stevemarple/FLC100_shield/README.md

FLC100_shield
=============

Shield for FLC100 fluxgate magnetometer
