stevemarple/FLC100_shield/hardware/remote_v1.1/FLC100_remote_v1.1.brd

## EAGLE design hardware/remote_v1.1/FLC100_remote_v1.1.brd (2012-09-07)

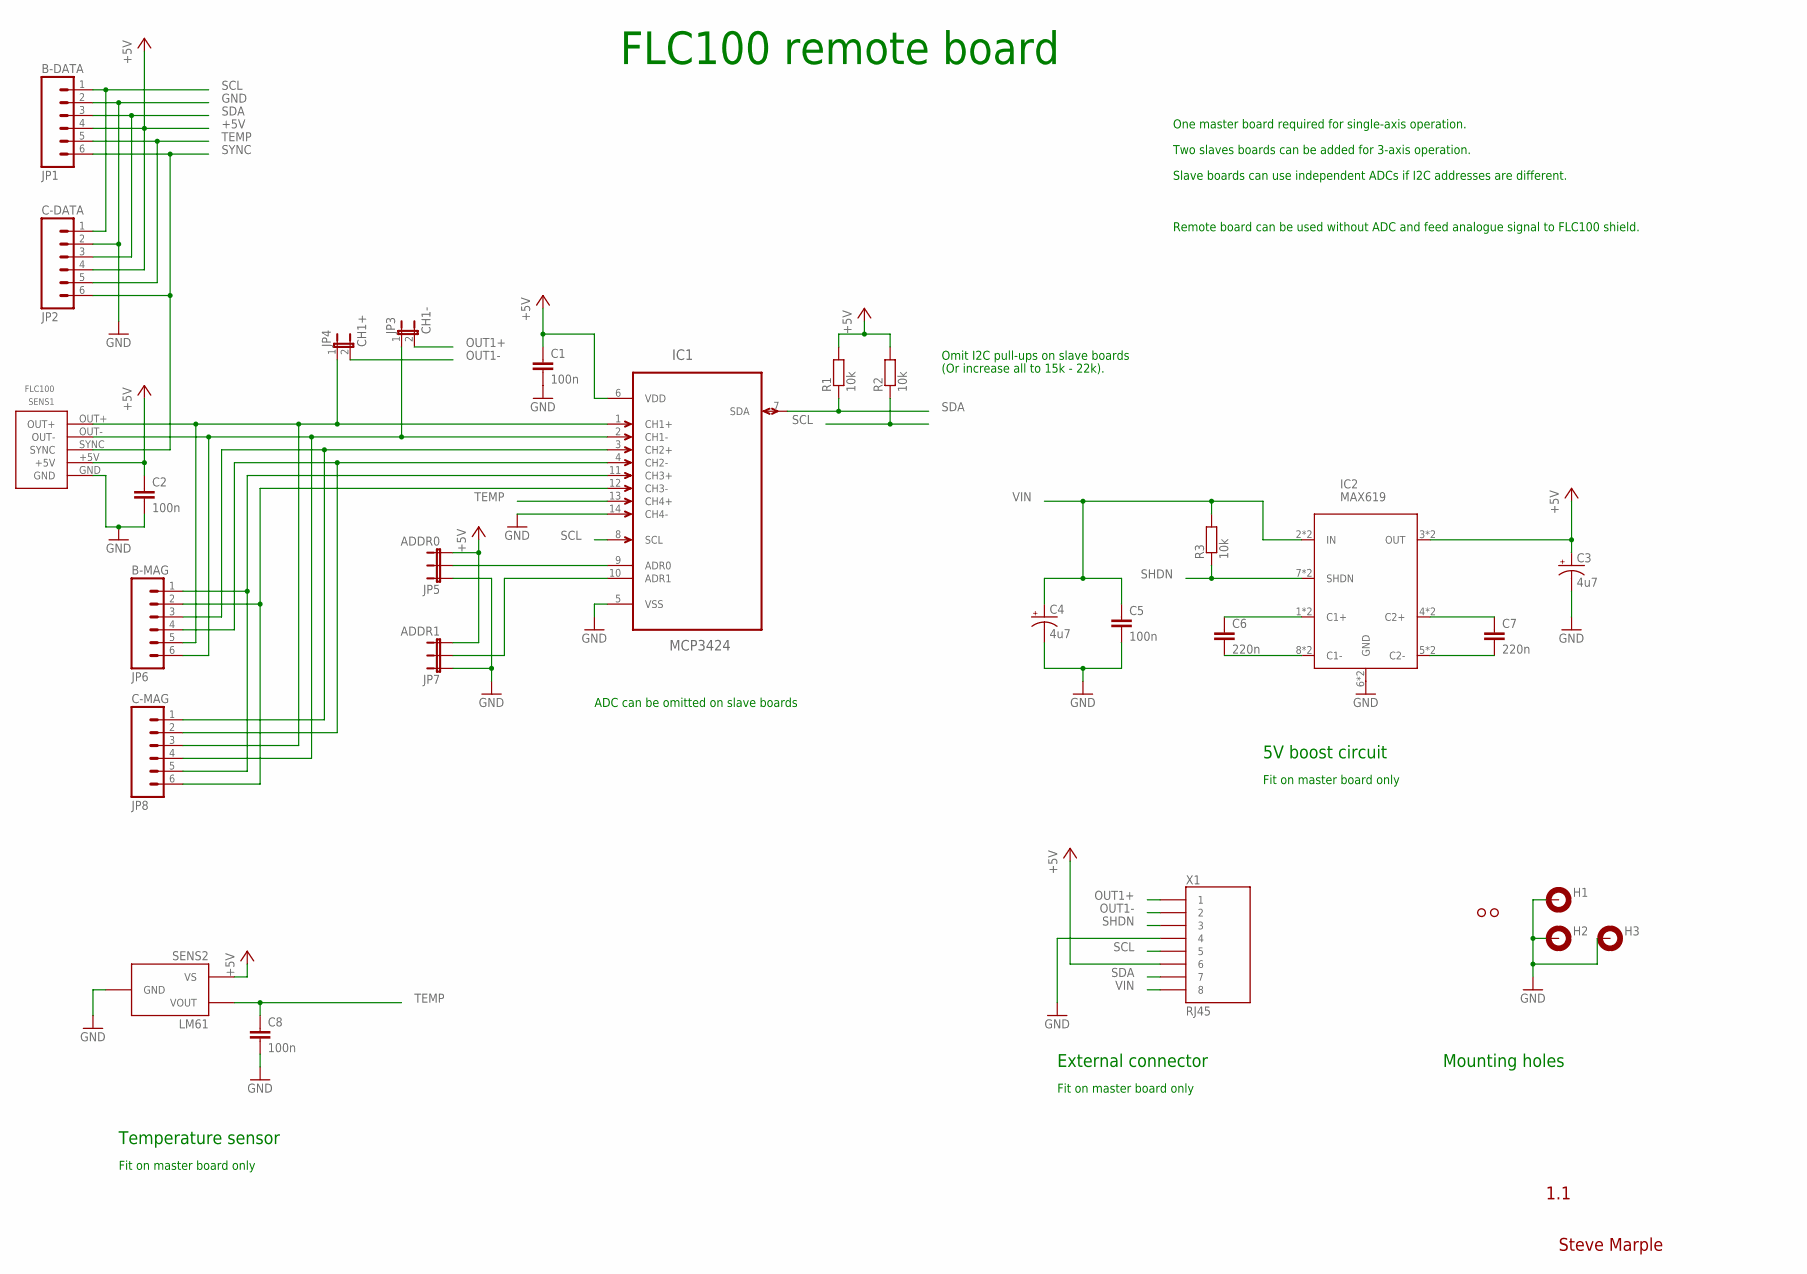
[picture p1: schematic FLC100_remote_v1.1.sch]

Parts:
C1, C2, C5, C8: 100n; CAP-PTH-SMALL
C3, C4: 4u7; CPOL-RADIAL-10UF-25V
C6, C7: 220n; CAP-PTH-5MM
H1, H2, H3: MOUNT-PAD-ROUND3.0; 3,0-PAD
IC1: MCP3424; SOIC127P600X175-14N
IC2: MAX619; DIL08-SOIC8
JP1: B-DATA; 1X06_FEMALE
JP2: C-DATA; 1X06_FEMALE
JP3: CH1-; 1X02
JP4: CH1+; 1X02
JP5: ADDR0; 1X03
JP6: B-MAG; 1X06_FEMALE
JP7: ADDR1; 1X03
JP8: C-MAG; 1X06_FEMALE
R1, R2, R3: 10k; RES-AXIAL-0.4
SENS1: FLC100
SENS2: LM61; TO-92
U$1, U$2: PAD
X1: RJ45; RJ45-8

Connections:
+5V: C1.1, C2.1, C3.1 (+), IC1.6 (VDD), IC2.3 (OUT), IC2.3@1 (OUT), JP1.4, JP2.4, JP5.3, JP7.3, R1.P$2 (2), R2.P$2 (2), SENS1.+5V, SENS2.1 (VS), X1.6
GND: C1.2, C2.2, C3.2 (-), C4.2 (-), C5.2, C8.2, H1.B3,0, H2.B3,0, H3.B3,0, IC1.5 (VSS), IC1.14 (CH4-), IC2.6 (GND), IC2.6@1 (GND), JP1.2, JP2.2, JP5.1, JP7.1, SENS1.GND, SENS2.3 (GND), X1.4
unnamed: IC1.1 (CH1+), JP4.1, JP6.5, JP8.3, SENS1.OUT+
unnamed: IC1.2 (CH1-), JP3.1, JP6.6, JP8.4, SENS1.OUT-
unnamed: IC1.3 (CH2+), JP6.3, JP8.1
unnamed: IC1.4 (CH2-), JP6.4, JP8.2
unnamed: C6.2, IC2.8 (C1-), IC2.8@1 (C1-)
unnamed: C6.1, IC2.1 (C1+), IC2.1@1 (C1+)
unnamed: IC1.11 (CH3+), JP6.1, JP8.5
unnamed: IC1.12 (CH3-), JP6.2, JP8.6
unnamed: IC1.9 (ADR0), JP5.2
unnamed: IC1.10 (ADR1), JP7.2
unnamed: C7.1, IC2.4 (C2+), IC2.4@1 (C2+)
unnamed: C7.2, IC2.5 (C2-), IC2.5@1 (C2-)
OUT1+: JP3.2, X1.1
OUT1-: JP4.2, X1.2
SCL: IC1.8 (SCL), JP1.1, JP2.1, R2.P$1 (1), X1.5
SDA: IC1.7 (SDA), JP1.3, JP2.3, R1.P$1 (1), X1.7
SHDN: IC2.7 (SHDN), IC2.7@1 (SHDN), R3.P$1 (1), X1.3
SYNC: JP1.6, JP2.6, SENS1.SYNC
TEMP: C8.1, IC1.13 (CH4+), JP1.5, JP2.5, SENS2.2 (VOUT)
VIN: C4.1 (+), C5.1, IC2.2 (IN), IC2.2@1 (IN), R3.P$2 (2), X1.8

Notes on the sheet:
1.1
Steve Marple
External connector
5V boost circuit
ADC can be omitted on slave boards
Fit on master board only
FLC100 remote board
One master board required for single-axis operation.
Two slaves boards can be added for 3-axis operation.
Slave boards can use independent ADCs if I2C addresses are different.
Remote board can be used without ADC and feed analogue signal to FLC100 shield.
Omit I2C pull-ups on slave boards
(Or increase all to 15k - 22k).
Mounting holes
Temperature sensor

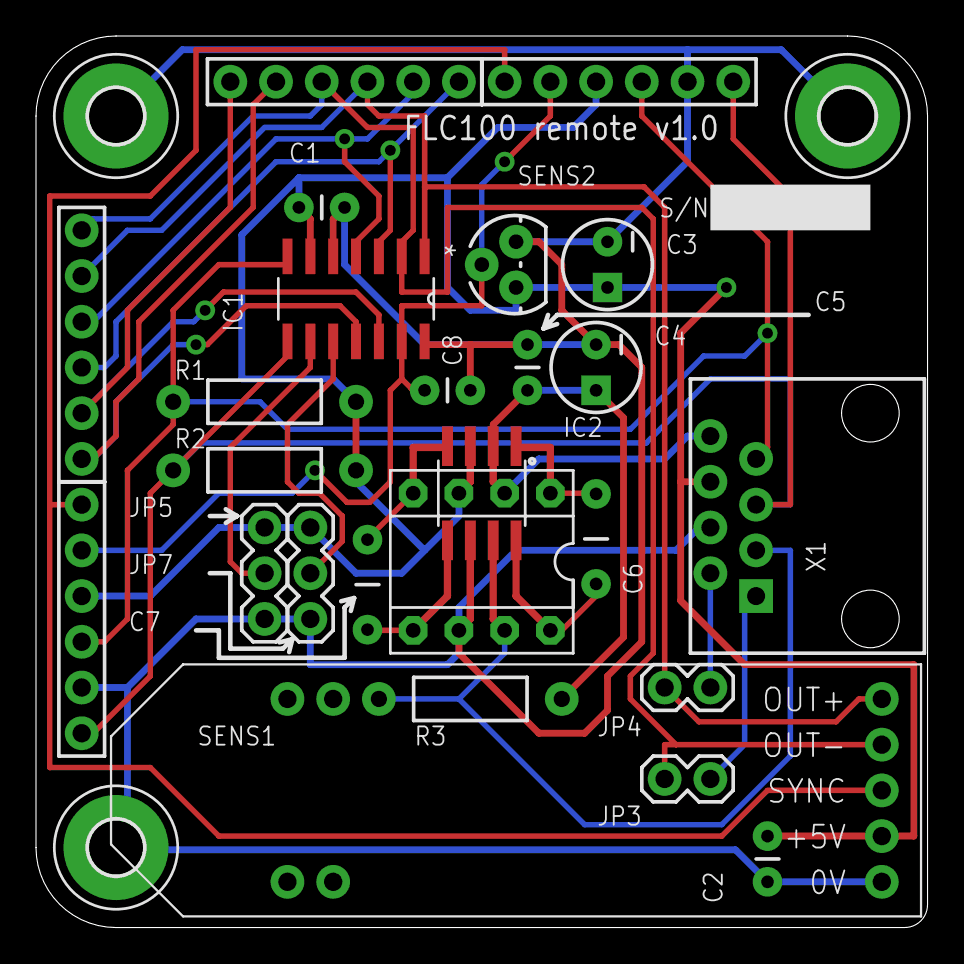
[picture p2: board FLC100_remote_v1.1.brd from above]

Board: 2 copper layers, 49.5 x 49.5 mm, 29 parts (0 on the bottom side), 22 nets.
