stevemarple/FLC100_shield/hardware/shield_v1.0/FLC100_shield_v1.0.brd

## EAGLE design hardware/shield_v1.0/FLC100_shield_v1.0.brd (2012-09-07)

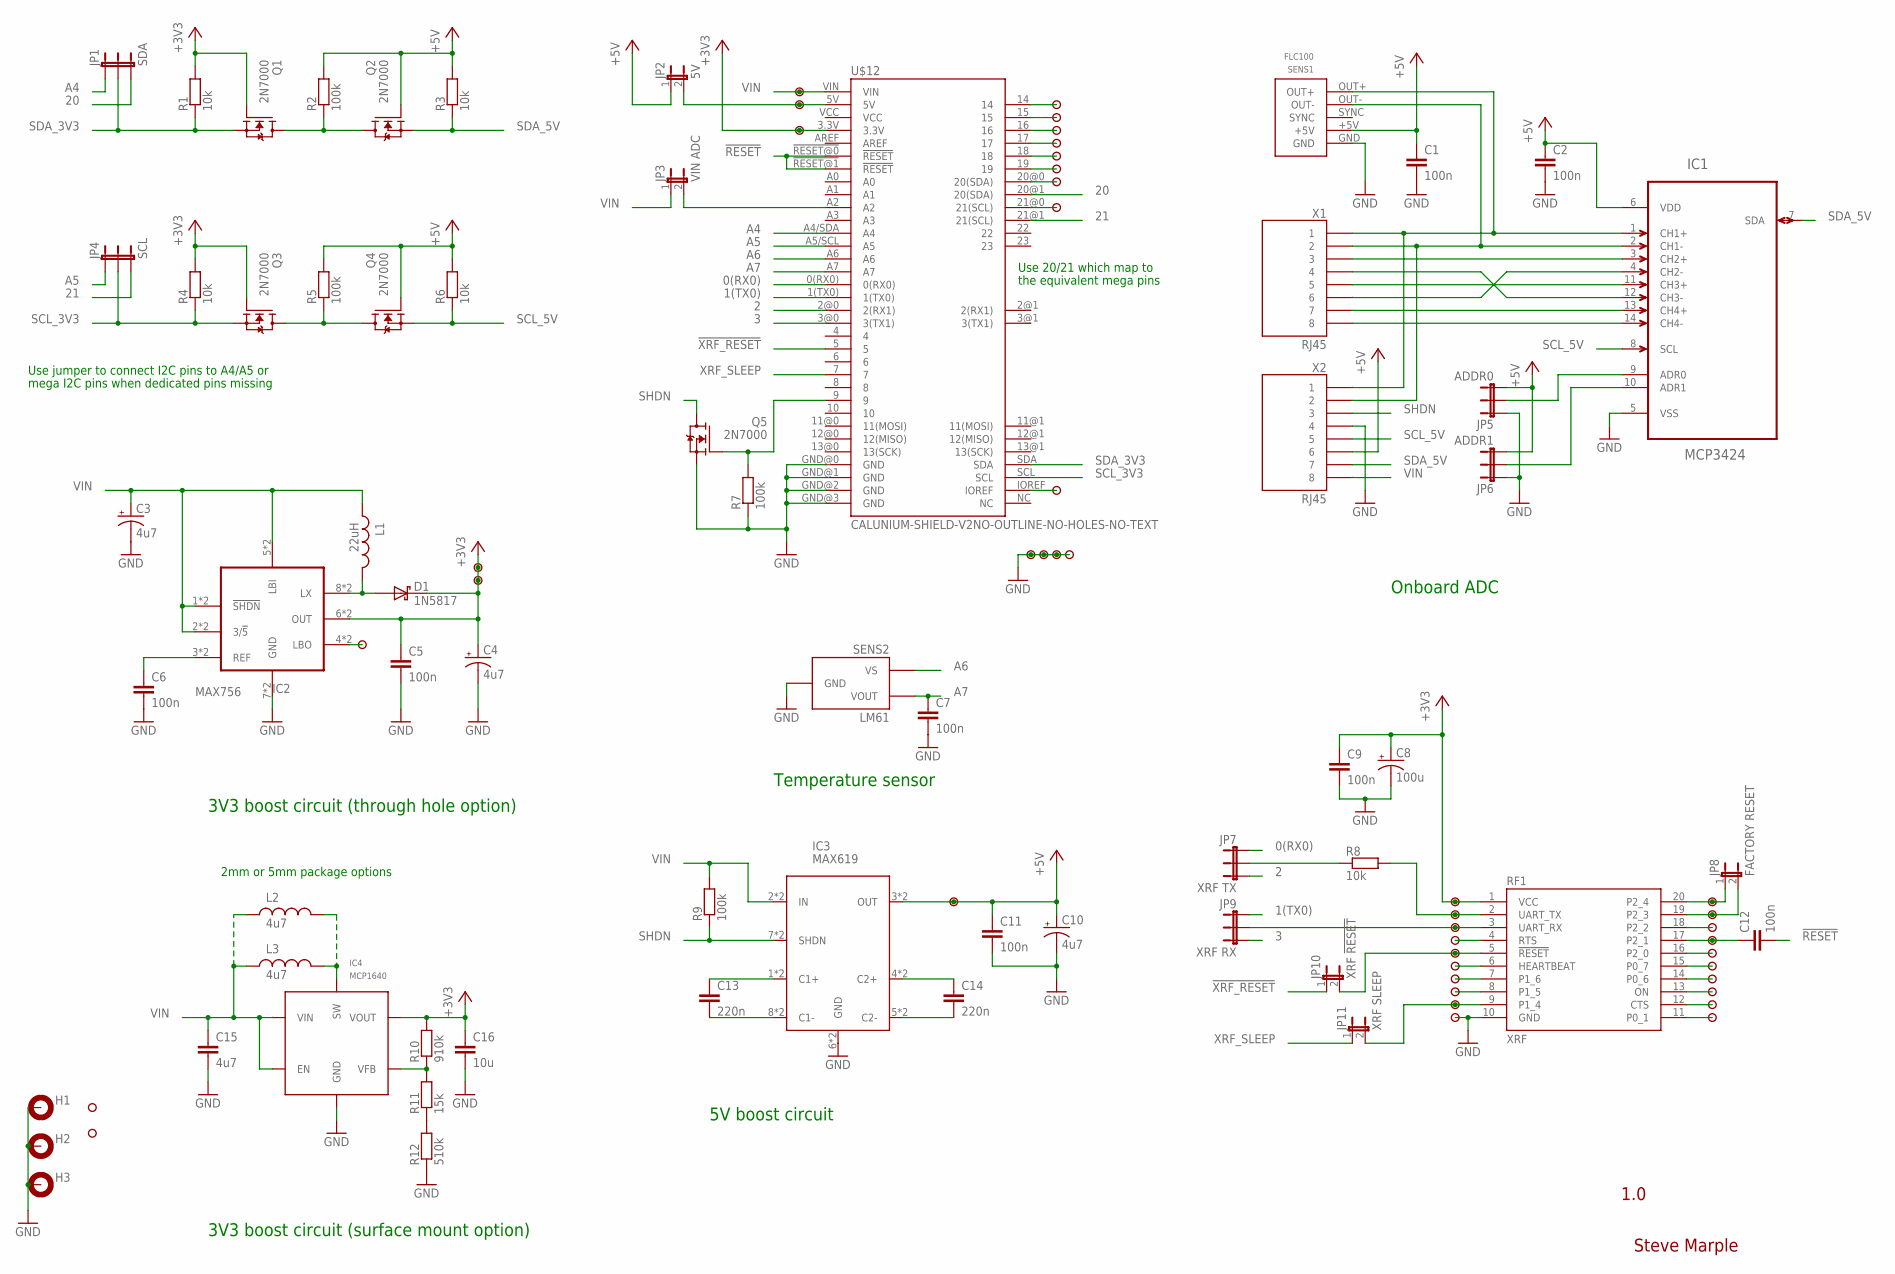
[picture p3: schematic FLC100_shield_v1.0.sch]

Parts:
C1, C2, C5, C6, C7, C9, C11, C12: 100n; CAP-PTH-SMALL
C3, C4, C10: 4u7; CPOL-RADIAL-10UF-25V
C8: 100u; CPOL-RADIAL-10UF-25V
C13, C14: 220n; CAP-PTH-5MM
C15: 4u7; 1206-HAND
C16: 10u; 1206-HAND
D1: 1N5817; DIODE-TH-0.4
H1, H2, H3: MOUNT-PAD-ROUND3.0; 3,0-PAD
IC1: MCP3424; SOIC127P600X175-14N
IC2: MAX756; DIL08-SOIC8
IC3: MAX619; DIL08-SOIC8
IC4: MCP1640; SOT23-6
JP1: SDA; 1X03
JP2: 5V; 1X02
JP3: VIN ADC; 1X02
JP4: SCL; 1X03
JP5: ADDR0; 1X03
JP6: ADDR1; 1X03
JP7: XRF TX; 1X03
JP8: FACTORY RESET; 1X02
JP9: XRF RX; 1X03
JP10: XRF !RESET; 1X02
JP11: XRF SLEEP; 1X02
L1: 22uH; INDUCTOR-TH-5MM
L2: 4u7; INDUCTOR-TH-2MM
L3: 4u7; INDUCTOR-TH-5MM
Q1, Q2, Q3, Q4, Q5: 2N7000; TO-92
R1, R3, R4, R6, R8: 10k; RES-AXIAL-0.4
R2, R5, R7, R9: 100k; RES-AXIAL-0.4
R10: 910k; 1206-HAND
R11: 15k; 1206-HAND
R12: 510k; 1206-HAND
RF1: XRF; XBEE
SENS1: FLC100
SENS2: LM61; TO-92
U$1, U$2, U$3, U$4, U$5, U$6, U$7, U$8, U$9, U$10, U$11, U$13, U$14, U$15, U$16, U$17, U$18, U$19, U$20, U$21, U$22, U$23, U$24, U$25, U$26, U$27, U$28, U$29, U$30, U$31, U$32, U$33, U$34, U$35, U$36, U$37, U$38, U$39, U$40, U$41, U$42, U$43: PAD
U$12: CALUNIUM-SHIELD-V2NO-OUTLINE-NO-HOLES-NO-TEXT; CALUNIUM-SHIELD-NO-OUTLINE-NO-HOLES-NO-TEXT-V2
X1, X2: RJ45; RJ45-8

Connections:
0(RX0): JP7.1, U$12.0(RX0)
1(TX0): JP9.1, U$12.1(TX0)
2: JP7.3, U$12.2@0 (2(RX1))
3: JP9.3, U$12.3@0 (3(TX1))
20: JP1.3, U$12.20@1 (20(SDA))
21: JP4.3, U$12.21@1 (21(SCL))
!RESET: C12.2, U$12.!RESET@0 (!RESET), U$12.!RESET@1 (!RESET)
!XRF_RESET: JP10.1, U$12.5
+3V3: C4.1 (+), C5.1, C8.1 (+), C9.1, C16.1, D1.C, IC2.6 (OUT), IC2.6@1 (OUT), IC4.5 (VOUT), Q1.2 (G), Q3.2 (G), R1.P$2 (2), R4.P$2 (2), R10.2, RF1.1 (VCC), U$5.1, U$12.3.3V, U$18.1, U$19.1, U$22.1
+5V: C1.1, C2.1, C10.1 (+), C11.1, IC1.6 (VDD), IC3.3 (OUT), IC3.3@1 (OUT), JP2.1, JP5.3, JP6.3, Q2.2 (G), Q4.2 (G), R2.P$2 (2), R3.P$2 (2), R5.P$2 (2), R6.P$2 (2), SENS1.+5V, U$21.1, X2.6
A4: JP1.1, U$12.A4/SDA (A4)
A5: JP4.1, U$12.A5/SCL (A5)
A6: SENS2.1 (VS), U$12.A6
A7: C7.1, SENS2.2 (VOUT), U$12.A7
CHECK1: IC1.9 (ADR0), JP5.2
CHECK2: IC1.10 (ADR1), JP6.2
GND: C1.2, C2.2, C3.2 (-), C4.2 (-), C5.2, C6.2, C7.2, C8.2 (-), C9.2, C10.2 (-), C11.2, C15.2, C16.2, H1.B3,0, H2.B3,0, H3.B3,0, IC1.5 (VSS), IC2.7 (GND), IC2.7@1 (GND), IC3.6 (GND), IC3.6@1 (GND), IC4.2 (GND), JP5.1, JP6.1, Q5.1 (S), R7.P$1 (1), R12.1, RF1.10 (GND), SENS1.GND, SENS2.3 (GND), U$12.GND@0 (GND), U$12.GND@1 (GND), U$12.GND@2 (GND), U$12.GND@3 (GND), U$14.1, U$15.1, U$16.1, U$17.1, U$40.1, X2.4
unnamed: Q1.3 (D), Q2.3 (D), R2.P$1 (1)
unnamed: Q3.3 (D), Q4.3 (D), R5.P$1 (1)
unnamed: C13.2, IC3.8 (C1-), IC3.8@1 (C1-)
unnamed: C13.1, IC3.1 (C1+), IC3.1@1 (C1+)
unnamed: C14.1, IC3.4 (C2+), IC3.4@1 (C2+)
unnamed: C14.2, IC3.5 (C2-), IC3.5@1 (C2-)
unnamed: JP8.1, RF1.20 (P2_4), U$23.1
unnamed: JP8.2, RF1.19 (P2_3), U$25.1
unnamed: R8.P$2 (2), RF1.2 (UART_TX), U$24.1
unnamed: JP9.2, RF1.3 (UART_RX), U$26.1
unnamed: RF1.4 (RTS), U$28.1
unnamed: JP10.2, RF1.5 (!RESET), U$30.1
unnamed: RF1.6 (HEARTBEAT), U$32.1
unnamed: RF1.7 (P1_6), U$34.1
unnamed: RF1.8 (P1_5), U$36.1
unnamed: JP11.2, RF1.9 (P1_4), U$38.1
unnamed: RF1.18 (P2_2), U$27.1
unnamed: C12.1, RF1.17 (P2_1), U$29.1
unnamed: RF1.16 (P2_0), U$31.1
unnamed: RF1.15 (P0_7), U$33.1
unnamed: RF1.14 (P0_6), U$35.1
unnamed: RF1.13 (ON), U$37.1
unnamed: RF1.12 (CTS), U$39.1
unnamed: RF1.11 (P0_1), U$41.1
unnamed: IC2.4 (LBO), IC2.4@1 (LBO), U$20.1
unnamed: Q5.2 (G), R7.P$2 (2), U$12.9
unnamed: JP3.2, U$12.A2
unnamed: JP7.2, R8.P$1 (1)
unnamed: JP2.2, U$2.1, U$12.5V
unnamed: D1.A, IC2.8 (LX), IC2.8@1 (LX), L1.P$2 (2)
unnamed: C6.1, IC2.3 (REF), IC2.3@1 (REF)
unnamed: IC1.1 (CH1+), SENS1.OUT+, X1.1, X2.1
unnamed: IC1.2 (CH1-), SENS1.OUT-, X1.2, X2.2
unnamed: IC1.3 (CH2+), X1.3
unnamed: IC1.4 (CH2-), X1.6
unnamed: IC1.11 (CH3+), X1.5
unnamed: IC1.12 (CH3-), X1.4
unnamed: IC1.13 (CH4+), X1.7
unnamed: IC1.14 (CH4-), X1.8
unnamed: U$11.1, U$12.21@0 (21(SCL))
unnamed: IC4.1 (SW), L2.P$2 (2), L3.P$2 (2)
unnamed: R11.1, R12.2
unnamed: U$3.1, U$12.14
unnamed: U$4.1, U$12.15
unnamed: U$6.1, U$12.16
unnamed: IC4.4 (VFB), R10.1, R11.2
unnamed: U$7.1, U$12.17
unnamed: U$8.1, U$12.18
unnamed: U$9.1, U$12.19
unnamed: U$10.1, U$12.20@0 (20(SDA))
unnamed: U$12.IOREF, U$13.1
SCL_3V3: JP4.2, Q3.1 (S), R4.P$1 (1), U$12.SCL
SCL_5V: IC1.8 (SCL), Q4.1 (S), R6.P$1 (1), X2.5
SDA_3V3: JP1.2, Q1.1 (S), R1.P$1 (1), U$12.SDA
SDA_5V: IC1.7 (SDA), Q2.1 (S), R3.P$1 (1), X2.7
SHDN: IC3.7 (SHDN), IC3.7@1 (SHDN), Q5.3 (D), R9.P$1 (1), X2.3
VIN: C3.1 (+), C15.1, IC2.1 (!SHDN), IC2.1@1 (!SHDN), IC2.2 (3/!5), IC2.2@1 (3/!5), IC2.5 (LBI), IC2.5@1 (LBI), IC3.2 (IN), IC3.2@1 (IN), IC4.3 (EN), IC4.6 (VIN), JP3.1, L1.P$1 (1), L2.P$1 (1), L3.P$1 (1), R9.P$2 (2), U$1.1, U$12.VIN, X2.8
XRF_SLEEP: JP11.1, U$12.7

Notes on the sheet:
1.0
Steve Marple
Use jumper to connect I2C pins to A4/A5 or
3V3 boost circuit (through hole option)
Use 20/21 which map to
the equivalent mega pins
2mm or 5mm package options
mega I2C pins when dedicated pins missing
3V3 boost circuit (surface mount option)
Onboard ADC
5V boost circuit
Temperature sensor

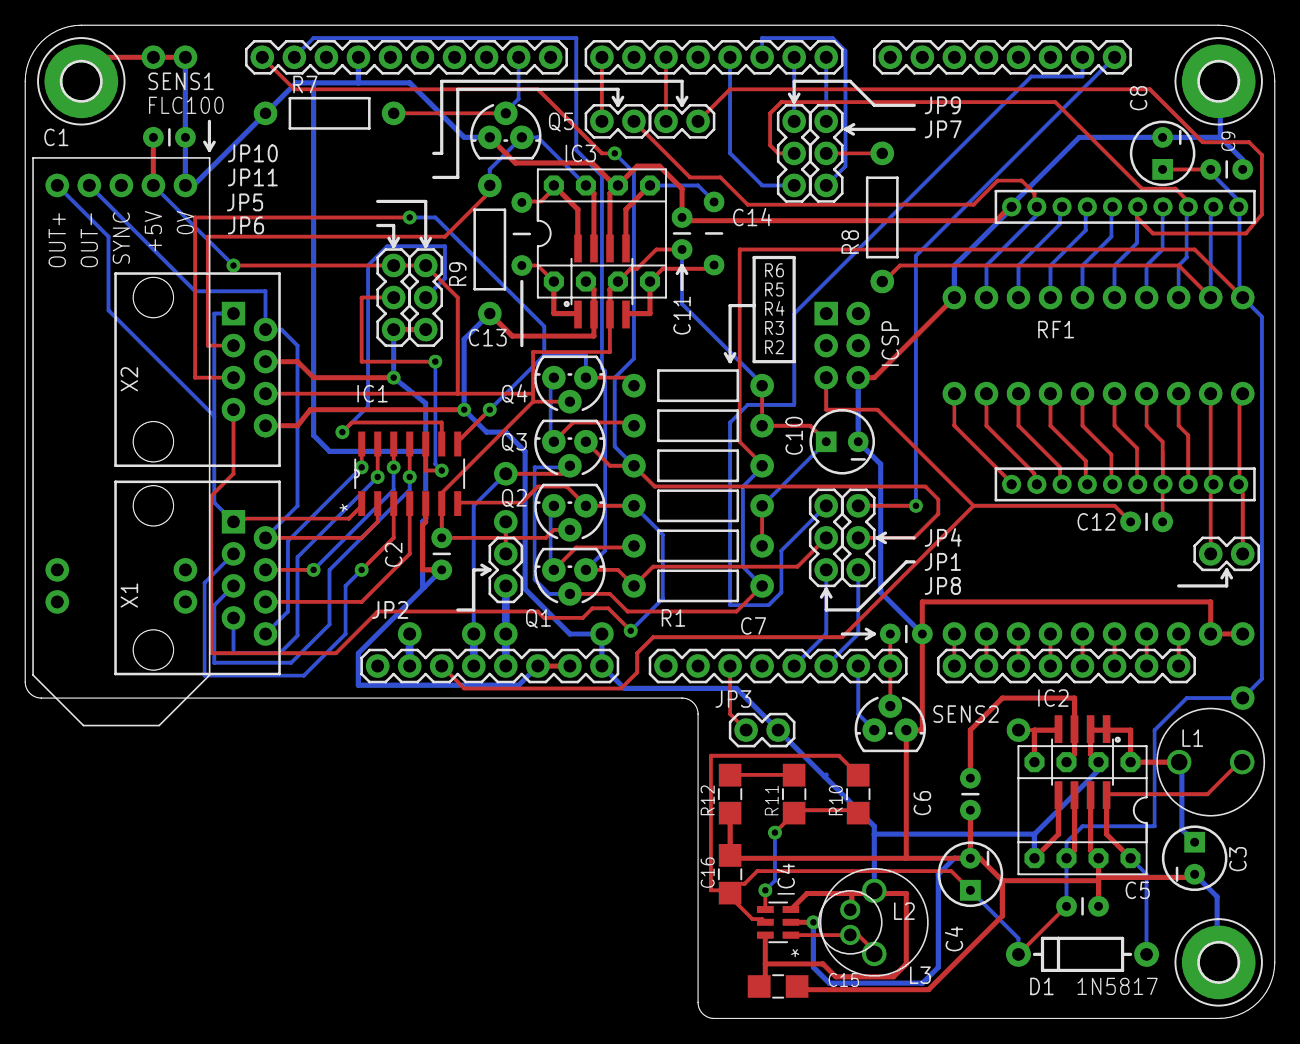
[picture p4: board FLC100_shield_v1.0.brd from above]

Board: 2 copper layers, 99.1 x 78.7 mm, 103 parts (0 on the bottom side), 75 nets.
