stevemarple/FLC100_shield/software/FLC100/FLC100.h

#ifndef FLC100_H
#define FLC100_H

#include <stdint.h>
#include <AsyncDelay.h>
#include <MCP342x.h>
#include <RTCx.h>

#define XRF_RESET 5
#define XRF_SLEEP 7
#define FLC100_POWER 9
#define FLC100_TEMPERATURE_CHANNEL 4
#define BATTERY_ADC 2
#define MCU_VCC_Vx100 3300
#define MCU_TEMPERATURE_ADC 7
#define MCU_TEMPERATURE_PWR A6

class FLC100;


class FLC100 {
public:
  static const uint8_t numAxes = 3;
    static const unsigned long powerUpDelay_ms = 1000;
  
  FLC100(void);
  inline bool initialise(uint8_t pp, uint8_t adcAddressList[numAxes],
			 uint8_t adcChannelList[numAxes]) {
    // Use temporary variable to ensure both functions are always called
    bool r = i2cHandler.initialise(pp, adcAddressList, adcChannelList);
    r = miscHandler.initialise() && r;
    return r;
  }

  inline bool isFinished(void) const {
    return i2cHandler.isFinished() && miscHandler.isFinished();
  }

  inline void start(void) {
    i2cHandler.start();
    miscHandler.start();
  }

  inline void process(void) {
    i2cHandler.process();
    miscHandler.process();
  }

  // Force completion/power-down
  inline void finish(void) {
    i2cHandler.finish();
    miscHandler.finish();
  }

  inline RTCx::time_t getTimestamp(void) const {
    return i2cHandler.getTimestamp();
  }
  inline int16_t getSensorTemperature(void) const {
    return i2cHandler.getSensorTemperature();
  }
  inline bool getAdcPresent(uint8_t n) const {
    return i2cHandler.getAdcPresent(n);
  }
  inline const int32_t* getMagData(void) const {
    return i2cHandler.getMagData();
  }
  inline const uint8_t* getMagResGain(void) const {
    return i2cHandler.getMagResGain();
  }
  inline int16_t getMcuTemperature(void) const {
    return miscHandler.getMcuTemperature();
  }
  inline uint16_t getBatteryVoltage(void) const {
    return miscHandler.getBatteryVoltage();
  }

  inline const int getI2CState(void) const {
    return i2cHandler.getState();
  }

private:
  
  // State machine for reading the magnetometer(s) and mag temperature
  class I2C {
  public:
    I2C(void);

    inline bool isFinished(void) const {
      return state == finished;
    }

    bool initialise(uint8_t pp, uint8_t adcAddressList[numAxes],
	uint8_t adcChannelList[numAxes]);
    inline void start(void) {
      state = poweringUp;
      digitalWrite(powerPin, HIGH);
      delay.start(powerUpDelay_ms, AsyncDelay::MILLIS);
    }

    void process(void);
    void finish(void);

    inline RTCx::time_t getTimestamp(void) const {
      return timestamp;
    }
    
    inline int16_t getSensorTemperature(void) const {
      return sensorTemperature;
    }

    inline bool getAdcPresent(uint8_t n) const {
      if (n >= numAxes)
	return false;
      return adcPresent[n];
    }

    inline const int32_t* getMagData(void) const {
      return magData;
    }

    inline const uint8_t* getMagResGain(void) const {
      return magResGain;
    }

    inline const int getState(void) const {
      return state;
    }
    
  private:
    enum state_t {
      off,
      poweringUp,
      readingTime,
      convertingTemp,
      readingTemp,
      configuringMags,
      convertingMags,
      readingMags,
      poweringDown,
      finished,
    };

    state_t state;
    uint8_t axis;
    uint8_t powerPin;

    MCP342x adc[FLC100::numAxes]; // X, Y, Z
    MCP342x::Config adcConfig[FLC100::numAxes];
    MCP342x::Config tempConfig;
    bool adcPresent[FLC100::numAxes];
    uint8_t addresses[FLC100::numAxes];
    uint8_t channels[numAxes];

    AsyncDelay delay;
    AsyncDelay timeout;

    // Data fields
    RTCx::time_t timestamp;
    int16_t sensorTemperature; // hundredths of degrees Celsius
    int32_t magData[numAxes];
    uint8_t magResGain[numAxes];
  };
  
  // State machine for reading MCU temperature and battery voltage
  class Misc {
  public:
    Misc(void);
    inline bool isFinished(void) const {
      return state == finished;
    }
    
    bool initialise(void);
    inline void start(void) {
      state = initialiseAdc;
    }

    void process(void);
    void finish(void);

    inline int16_t getMcuTemperature(void) const {
      return mcuTemperature;
    }
    inline uint16_t getBatteryVoltage(void) const {
      return batteryVoltage;
    }

  private:
    enum state_t {
      off,
      initialiseAdc,
      initialiseMcuTemp,
      getMcuTemp,
      initialiseVoltage,
      getVoltage,
      poweringDown,
      finished,
    };

    state_t state;
    
    // Data fields
    int16_t mcuTemperature; // hundredths of degrees Celsius
    uint16_t batteryVoltage; // hundredths of volt
  };

  I2C i2cHandler;
  Misc miscHandler;
  
};




  

#endif
