stevemarple/FLC100_shield/(commit log)

2012-08-21 Adding v1.0 schematic and board design.
    [FLC100_shield_v1.0.brd, FLC100_shield_v1.0.sch]
2012-09-07 Adding files used for first production run.
    [FLC100_remote_v1.1.brd, FLC100_remote_v1.1.sch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]
